Lemonade052/STM32_FreeRTOS_MotorControl_Gimbal_FOC/GimbalCAD/design_v3/gimbal_assembly.step

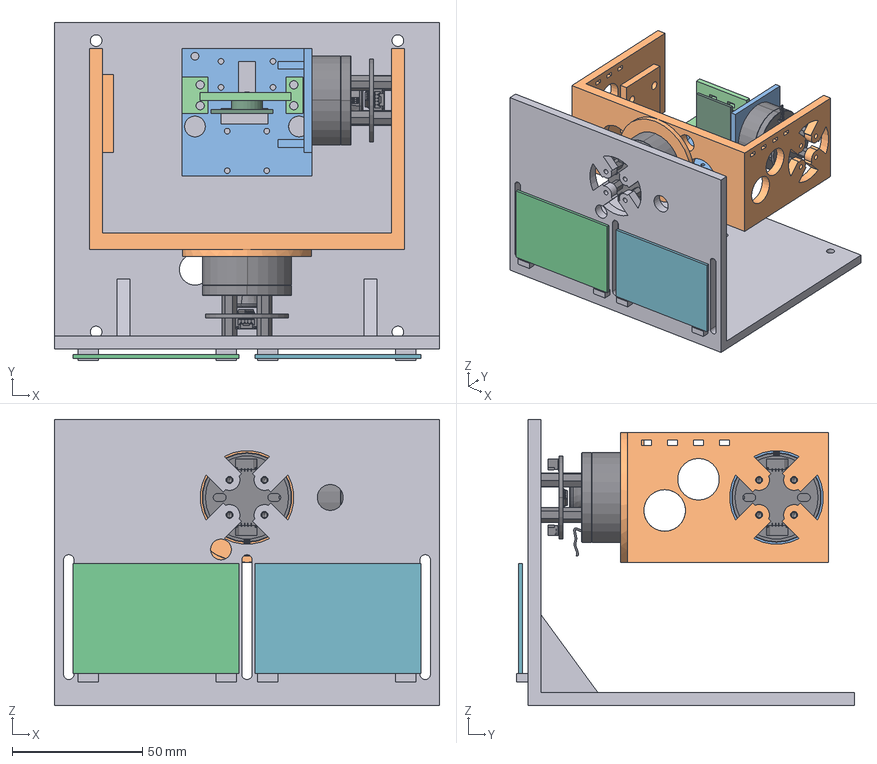
[picture p7: CAD file, 2026-10-27]
GimbalCAD/design_v3/gimbal_assembly.step
148.0 x 130.0 x 110.0 mm
01_base
02_roll_yoke
03_payload
03b_camera_bracket_v2
ref_camera_v2
ref_roll_motor_2804
ref_pitch_motor_2804
ref_roll_control_board
ref_pitch_control_board
