Lemonade052/STM32_FreeRTOS_MotorControl_Gimbal_FOC/GimbalCAD/design_v3/parts/03_payload.step

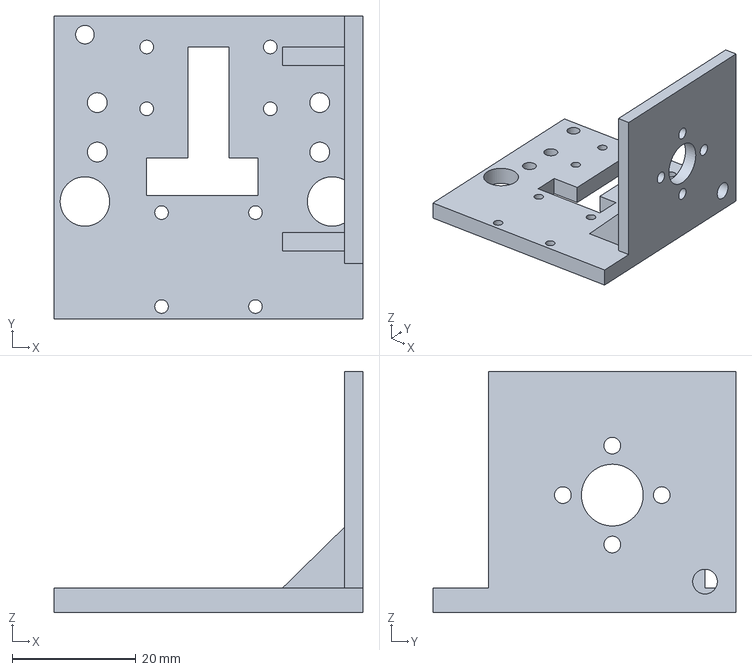
[picture p8: CAD file, 2026-10-27]
GimbalCAD/design_v3/parts/03_payload.step
50.0 x 49.0 x 39.0 mm
