Lemonade052/STM32_FreeRTOS_MotorControl_Gimbal_FOC/GimbalCAD/design_v3/parts/03b_camera_bracket.step

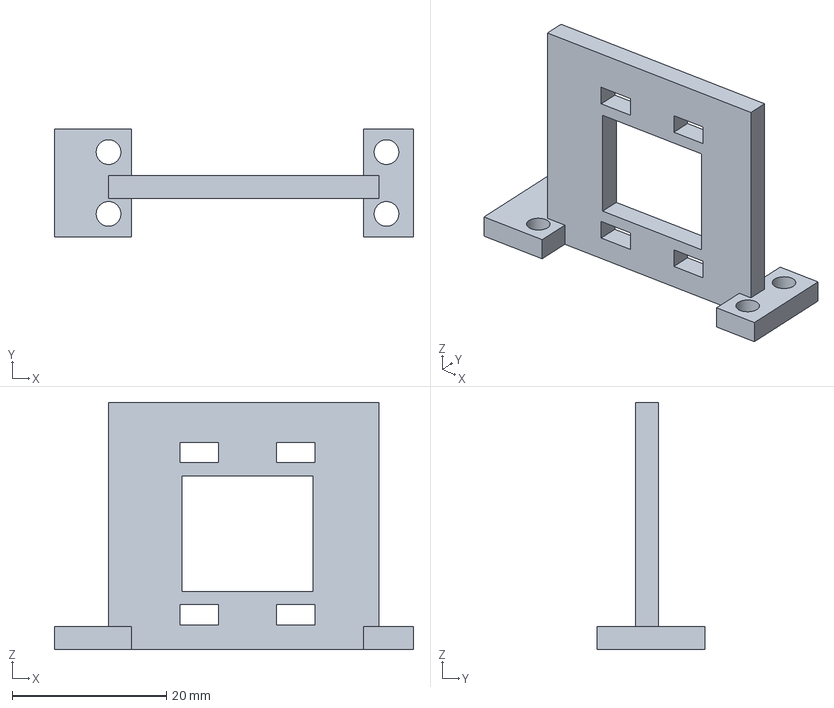
[picture p9: CAD file, 2026-10-27]
GimbalCAD/design_v3/parts/03b_camera_bracket.step
46.5 x 14.0 x 32.0 mm
