Lemonade052/STM32_FreeRTOS_MotorControl_Gimbal_FOC/GimbalCAD/design_v3/parts/05_rotor_test.step

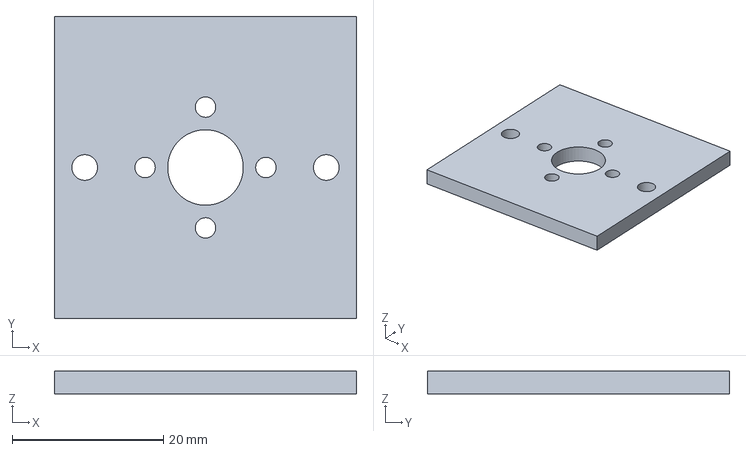
[picture p10: CAD file, 2026-10-27]
GimbalCAD/design_v3/parts/05_rotor_test.step
40.0 x 40.0 x 3.00 mm
