Lemonade052/STM32_FreeRTOS_MotorControl_Gimbal_FOC/GimbalCAD/design_v3/parts/01_base.step

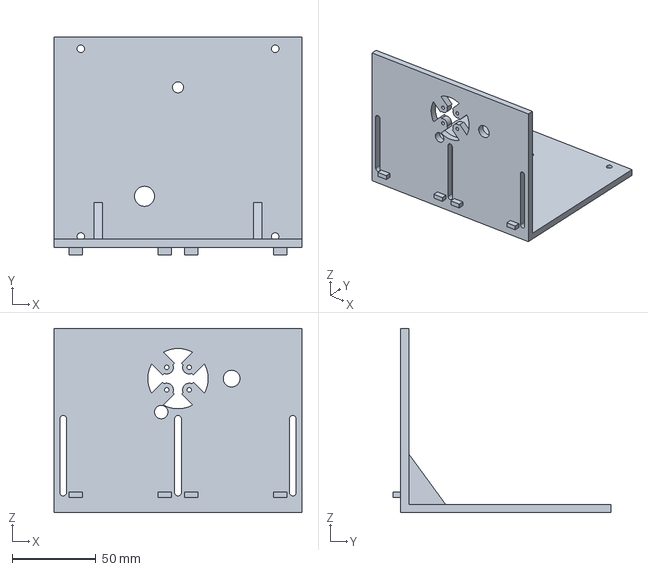
[picture p11: CAD file, 2026-10-27]
GimbalCAD/design_v3/parts/01_base.step
148.0 x 130.0 x 110.0 mm
