Lemonade052/STM32_FreeRTOS_MotorControl_Gimbal_FOC/GimbalCAD/design_v3/parts/02_yoke.step

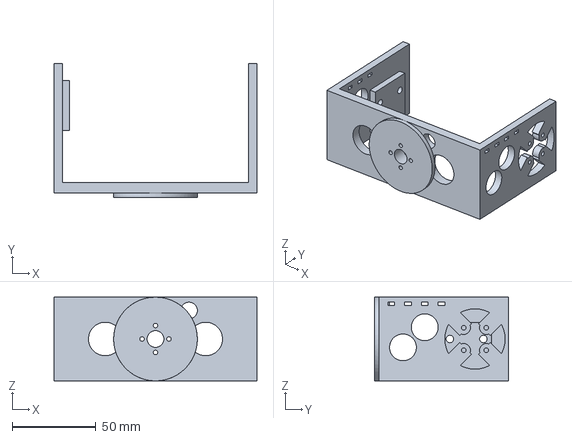
[picture p12: CAD file, 2026-10-27]
GimbalCAD/design_v3/parts/02_yoke.step
121.2 x 80.0 x 50.0 mm
