Lemonade052/STM32_FreeRTOS_MotorControl_Gimbal_FOC/GimbalCAD/design_v3/parts/04_mount_test.step

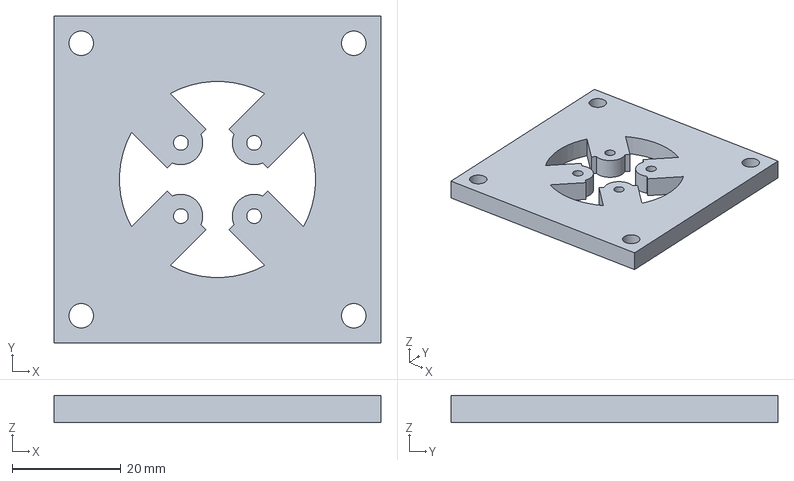
[picture p13: CAD file, 2026-10-27]
GimbalCAD/design_v3/parts/04_mount_test.step
60.0 x 60.0 x 5.00 mm
