Lemonade052/STM32_FreeRTOS_MotorControl_Gimbal_FOC/STM32FreeRtos/Core/Inc/main.h

#define IN1_Pin GPIO_PIN_14
#define IN1_GPIO_Port GPIOC
#define IN2_Pin GPIO_PIN_15
#define IN2_GPIO_Port GPIOC
#define LED2_Pin GPIO_PIN_0
#define LED2_GPIO_Port GPIOB
