Lemonade052/STM32_FreeRTOS_MotorControl_Gimbal_FOC/(commit log)

2026-10-05 第一版：有刷PID闭环
2026-10-06 更新：队列传角度＋转速
2026-10-27 更新：Arduino (stm32)烧录、云台CAD及STEP、自绘PCB开发套件板与实物图、实物连接与调试（横滚轴通过）
