Lemonade052/STM32_FreeRTOS_MotorControl_Gimbal_FOC/(notices)

Notices in the files:
STM32FreeRtos/Core/Inc/main.h:
Copyright (c) 2026 STMicroelectronics.
All rights reserved.
This software is licensed under terms that can be found in the LICENSE file
